ttrang126/Digital_Control_System/Digital Control_Group12.pdf

HANOI UNIVERSITY OF SCIENCE AND TECHNOLOGY SCHOOL OF ELECTRICAL AND ELECTRONIC ENGINEERING

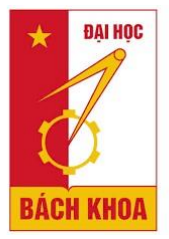
[picture p1: figure]

## PROJECT REPORT

## DIGITAL CONTROL DESIGN

## Topic: Three – phase DC/AC Inverter

## Instructor: Asso.Prof. Vu Thi Thuy Nga

Student Name | Student’s ID
Trịnh Hà Trang | 20200630
Nguyễn Thế Anh | 20200034
Nguyễn Bùi Thành An | 20202730
Nguyễn Hoàng Minh | 20207619

Ha Noi, 2024

TABLE OF CONTENTS

IMAGE INDEX

TABLE INDEX

CHAPTER 1. INTRODUCTION

### 1.1 DC/AC inverter

A DC-AC inverter is a device that converts direct current (DC) electricity into alternating current (AC) electricity. it takes power from a DC source, such as a battery or a solar panel, and transforms it into AC power that can be used to run appliances, electronic devices, or be fed into the electrical grid. The process involves changing the voltage level and waveform from the DC input to match the required characteristics of the AC output. The most common type of waveform for AC power is a sine wave, but some inverters may produce a modified sine wave or a square wave, which is generally suitable for simpler electronic devices.

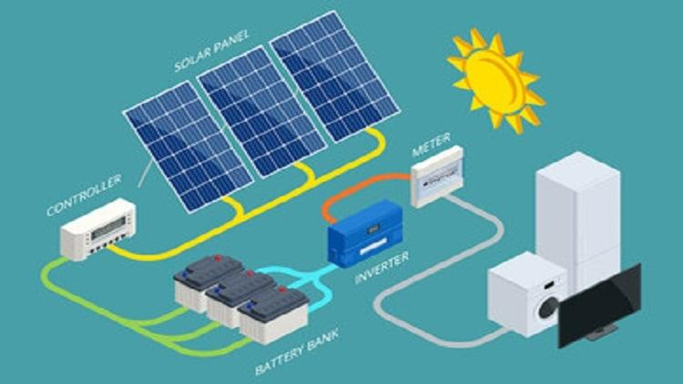
[picture p2: figure]

Figure 1. An example of an inverter application When it comes to voltage source inverter(VSI) there are two common types: the single-phase and the three phase one. While the single-phase voltage source inverter (VSI) covers low-power applications, the three- phase VSI outperforms in the medium to high-power range, and the output of the three-phase VSI can be either synchronized with the grid voltage or only supply a residential load, depending on the applications and consumers power demand. There are two types of three-phase VSI: grid-tied and off-grid inverters, each of which is installed in a different circumstance and has different requirements. Off-grid three-phase VSI, which provide conditioned and uninterrupted power to critical loads such as telecommunication systems, data centers, airline computers, medical systems, and even an industrial site or a rural community when power outages occur by transferring backup energy stored in batteries, is widely used in Uninterruptible Power Supply (UPS) systems.
Furthermore, in recent years, both standby and grid-tied three-phase VSI have been seen being implemented in a Distributed Generation System (DGS) using renewable sources such as solar cells, fuel cells, wind turbines, biomass, and so on to relieve the burden on conventional grid utilities while meeting strict environmental requirements. When the DGS system is linked in parallel with the main grid, the three-phase VSI not only injects appropriate AC power into the grid, but it also contains features that deal with the islanding effect and provides grid inspection.

### 1.2 Structure & Working Principle

Figure 2 demonstrates the standard three-phase VSI structure. A three-phase VSI typically consists of two major components, the first of which is a DC voltage source. The DC voltage source can come from a storage bank such as a battery, a supercapacitor, or the output of a previous DC-DC converter. A DC-link capacitor after the input DC voltage source may be required in some cases to maintain a constant voltage across the inverter and protect it from voltage spikes, surges, and electromagnetic interference (EMI).

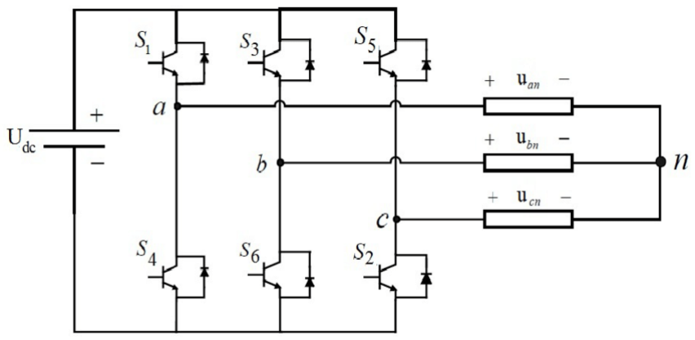
[picture p3: figure]

Figure 2. Standard 3-phase inverter Furthermore, the inverter is made up of six fully adjustable power switches that might be implemented with semiconductor devices such as GTOs, MOSFETs, or IGBTs. These devices are typically chosen depending on the switching frequency and power capacity requirements. Allowing the switches to conduct at the same time will result in a short circuit across the DC source. Similarly, the switches should not be turned off at the same time to avoid undefined output AC voltages and VSI states. In addition, when driving an inductive load, antiparallel diodes (or inverse-parallel diodes) must be added to provide reverse current routes to the source when the switch is turned off.
The correct output waveform of the three-phase inverter can be seen in Figure 3 below. In this figure the voltage is controlled by the SVPWM carrier signal. It is important to note that the waveform should be sine to optimally reduce harmonica and disturbances.

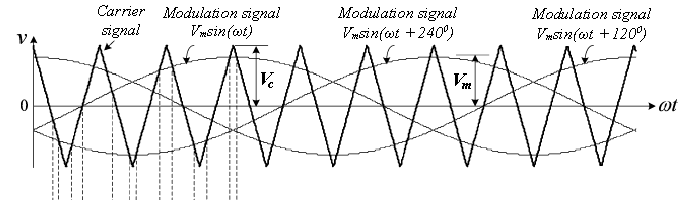
[picture p4: figure]

Figure 3. Ideal output waveform of the three-phase inverter

### 1.3 Design Criteria

### 1.3.1. For inverter design

Rated power | 48VA
Input DC voltage | 24V
Output voltage | 12V (RMS)
Output fundamental frequency | 50Hz
Power factor | 0.8
Maximum clock frequency | 80MHz
Sensor | Voltage Sensor, Current Sensor

### 1.3.2. For controller design

- Expect no overshoot.
- Short settling time
- Low harmonic distortion
- Can work with different type of loads.
For this project we will only use resistance load.

CHAPTER 2. SYSTEM MODELING AND CONTROL DESIGN

### 2.1. Space Vector Pulse Width Modulation (SVPWM)

SVPWM is a modulation technique used to control the voltage applied to a three-phase electric motor, whether it is a permanent magnet or an induction machine. The purpose is to generate a three-phase sinusoidal waveform with adjustable frequency and amplitude using a constant DC voltage and six switches, such as transistors. To apply SVPWM, the Clark Transformation method must be employed.

### 2.1.1. Clark Transformation

Consider the three-phase voltage/current system X = (Xa, Xb, Xc

) and Xa = Xb = Xc = 0.

By Clark transformation, it equals to a space vector:

u̅ =

2
3

(ua + aub + a

2uc)

where a = e

j

2π
3 = −

1
2

+ j

√3
2
Express on alpha – beta axis:

{

Uα =

1
3

(2uA − uB − uC

)

Uβ =

1
√3

(uB − uC)

Express by transformation matrix:

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
[uA | uB | uC]

= T1

[uA | uB | uC]

If
{

uA = U

mcos (ωt)

uB = U

m cos (ωt −
2π
3

)

uC = U

m cos (ωt +
2π
3

)

Then u̅ is rotating vector: u̅ = U

me

j(ωt)

### 2.1.2. Working principle of SVPWM

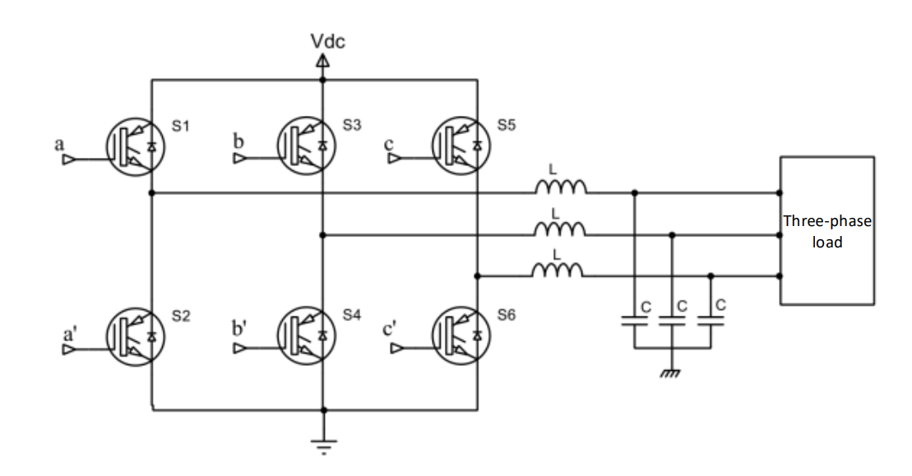
[picture p5: figure]

Figure 4. Three phase voltage source PWM inverter The circuit model of a typical three-phase voltage source SVPWM inverter is shown in Fig. 4. S1 to S6 are the six power switches that shape the output, which are controlled by the switching variables a, a′, b, b′, c and c′. When an upper transistor is switched on, i.e., when a, b or c is 1, the corresponding lower transistor is switched off, i.e., the corresponding a′, b′ or c′ is 0. Therefore, the on and off states of the upper transistors S1, S3 and S5 can be used to determine the output voltage.
There are eight possible combinations of on and off patterns for the three upper power switches. The on and off states of the lower power devices are opposite to the upper one and so are easily determined once the states of the upper power transistors are determined. The relationship between the vector space and the corresponding switching states is shown in Table 1.

Table 1. Switching states and voltage values of the vectors

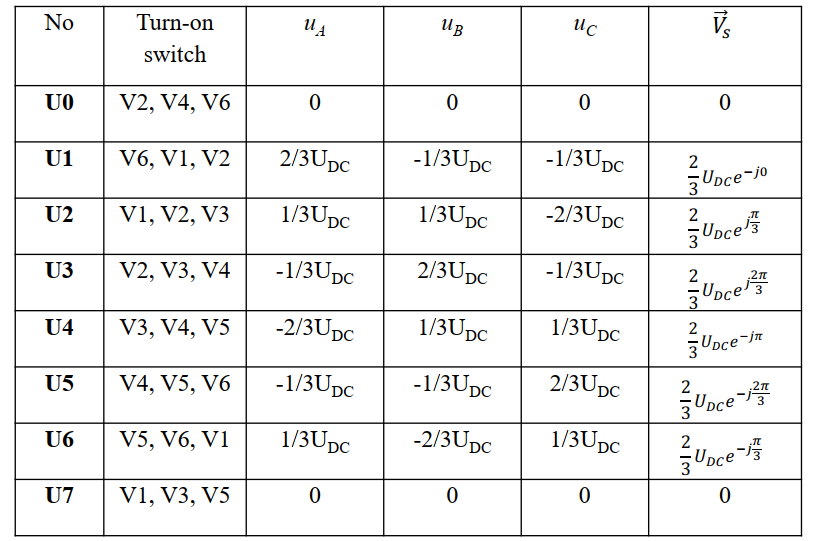
[picture p6: figure]

The space vector diagram is depicted in Fig 5.

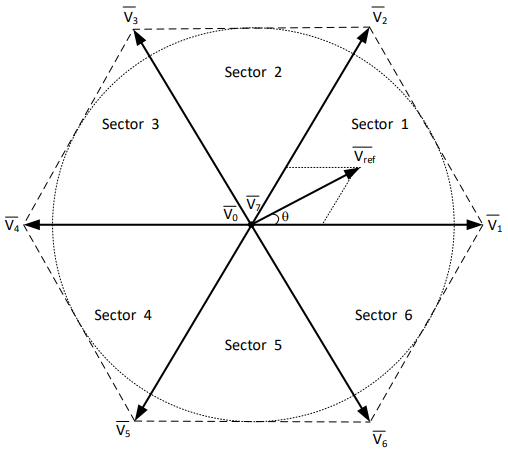
[picture p7: figure]

Figure 5. Voltage Space Vectors To generate a sinusoidal three-phase voltage for the motor we have to construct a vector that rotates in plane space called the reference voltage vector Vref ⃗⃗⃗⃗⃗ . The reference voltage

vector rotates in space with angular velocity ω = 2πf , where f is the fundamental frequency of the drive output voltage. As a result, when the reference voltage vector rotates one revolution in the space plane, the drive output changes one electrical cycle over time. The inverter's output frequency is equal to the rotation speed of the reference voltage vector.
The usual implementation of SVPWM involves the following steps:

(1) The coordinate transformation for the reference vector Vref ⃗⃗⃗⃗⃗ . from a rotating frame

to a stationary one.
(2) Define the time interval T1, T2, and T0.
(3) Determine the switching time of each Transistor (S1 - S6). The inverter cannot directly generate the desired reference voltage vector. The reference vector can be decomposed into two component vectors that lie on two other nonadjacent vectors and two zero vectors at the origin of the coordinate. Fig. 6 shows space vector PWM switching patterns at each sector.

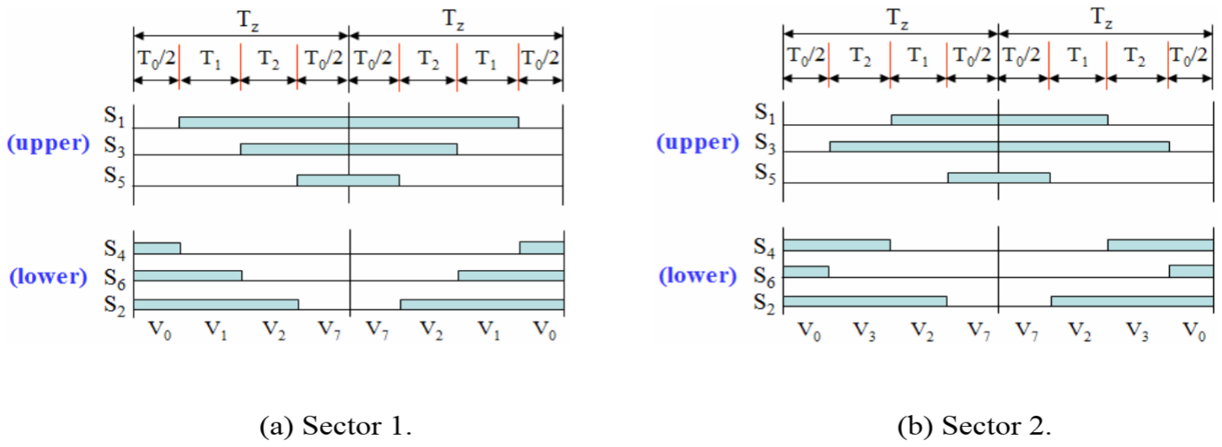
[picture p8: figure]
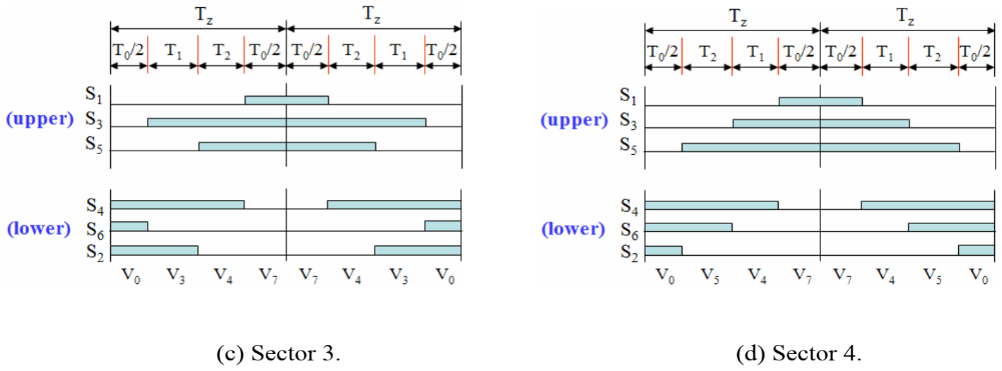
[picture p9: figure]
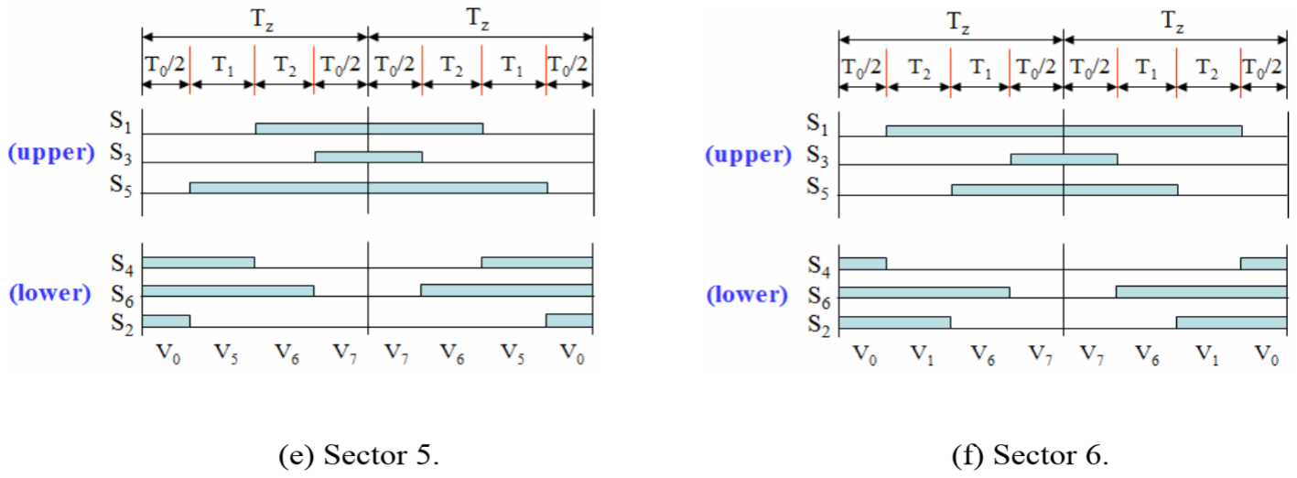
[picture p10: figure]

Figure 6. Space Vector PWM switching patterns at each sector

### 2.2. Mathematical Modeling of Three – phase Inverter

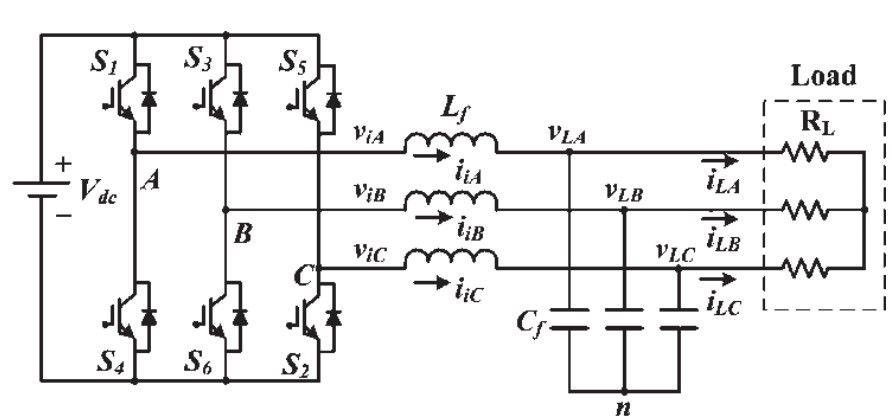
[picture p11: figure]

Figure 7. Schematic diagram of the three-phase inverter with resistance load

T Vi = [ViA ViB ViC] | Inverter output line to neutral voltage vector
Ii = [IiA IiB IiC] T | Inverter phase current vector
VL = [VLA VLB VLC] T | Load line to neutral voltage vector
T IL = [ILA ILB ILC] | Load phase current vector
T Vid-q = [Vid Viq] | d-q frame voltage vector of Vi
Iid-q = [Iid Iiq] T | d-q frame current vector of Ii
VLd-q = [VLd VLq] T | d-q frame voltage vector of VL
T Viα-β = [Viα Viβ] | α-β frame voltage vector of Vi
T Iiα-β = [Iiα Iiβ] | α-β frame current vector of Ii
VLα-β = [VLα VLβ] T | α-β frame voltage vector of VL

Fig. 7 illustrates a three-phase DC-AC inverter, incorporating an LC filter. The system includes a three-phase inverter (S1 to S6), output filters (Lf and Cf), a three-phase

resistive load (RL

), and a DC voltage source (VDC). The LC filter is a critical component of this circuit, responsible for eliminating harmonic components of the inverter's output voltage resulting from high frequency switching actions.
Applying Kirchoff’s Voltage Law and Kirchoff's Current Law at the output of the LC filter, we obtain:

{

dVL
dt

=
Cf

Ii −
Cf

IL

dIi
dt

+

rL
Lf

Ii =

1
Lf

Vi −

1
Lf

VL

(1)

Clark Transformation:

Xαβ = xae

j0 + xbe

j

2π
3 +xce

j

4π
3
where Xαβ = xα + jxβ

Eq. 1 can be transformed to the following:

{

dVLαβ
dt =

1
Cf

Iiαβ −

1
Cf

ILαβ

dIiαβ
dt +

rL
Lf

Iiαβ =

1
Lf

Viαβ −

1
Lf

VLαβ

(2)

Park Transformation:
Xdq = xd + jxq = Xαβe

−jθ

where θ(t) = ∫ ω(τ)dτ + θo

t
0

is the transformation angle, ω is the angular frequency (ω = 2πf)

Eq. 2 can be transformed to the following:

{

dVLdq
dt + jωVLdq =

1
Cf

Iidq −

1
Cf

ILdq

dIidq
dt +

rL
Lf

Iidq + jωILdq =

1
Lf

Vidq −

1
Lf

VLdq

(3)

Eq. 3 can be expressed as:

{

v̇Ld = ωvLq −

1
Cf

iLd +

1
Cf
iid | (4)

v̇Lq = −ωvLd −

1
Cf

iLq +

1
Cf
iiq | (5)

iiḋ +

rL
Lf

iid = −

1
Lf

vLd + ωiiq +

1
Lf
vid | (6)

iiq̇ +

rL
Lf

iiq = −

1
Lf

vLq − ωiid +

1
Lf
viq | (7)

### 2.3. Control design

The block diagram of the three – phase inverter control is shown in Fig 9.

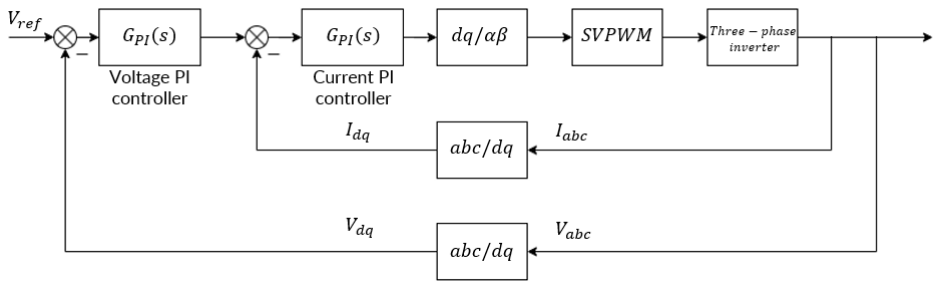
[picture p12: figure]

Figure 8. Block diagram of the three - phase inverter control

To approach the digital control of this system, we decided to first design the system in continuous domain, find the parameters for the continuous PI controllers and from that, approximate to find the parameters for the discrete PI controllers. The transfer function of PI controller is:
GPI(s) = KP (1 +

1
Tis
) | (8)

A two-loop design is considered in this project, with the outer loop is the voltage loop which uses the output voltage as feedback, while the inner loop is the current loop. The design sequence is to first starts with the current loop, then the voltage loop. Note that since the two-loop is designed in dq frame, there exists a cross-coupling between d and q-axis components in both loops, which reduces the overall dynamic and steady-state of the system. It is essential to use decoupling methods to avoid the mentioned phenomena.

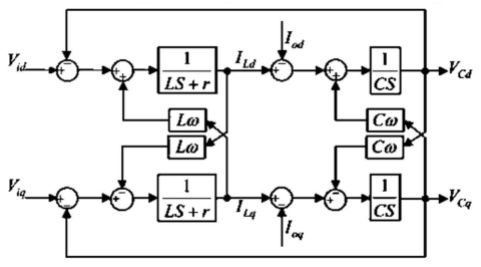
[picture p13: figure]

Figure 9. Decoupling methodology for three – phase inverter modeling in dq frame

### 2.3.1. Inner current control loop

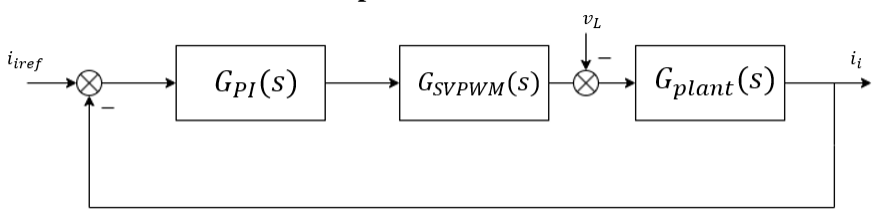
[picture p14: figure]

Figure 10. Block diagram of the current control loop

From (6), (7), we have
{
Lf

dvid
dt

+ rL

iid = −vLd + Lfωiiq + vid

Lf

viq
dt

+ rL

iiq = −vLq − Lfωiid + viq

(9)

It is clearly seen in Eq. (9) that the injected AC current can be controlled by regulating the output voltage of the DC/AC converter. However, the d- and q- axis output
currents | are | coupled | to | each | other, | leading | to | a | slightly | complicated
system from the control perspective. In addition, the load voltage also has an influence on the control dynamics. Therefore, the output voltage references (i.e., vid,ref and viq,ref ) are modified by means of adding one decoupling term and

one feed-forward voltage as
{

vid,ref = −vLd + ωLfiiq + vid

viq,ref = −vLq − ωLfiid + viq

| | | | | | | | | | (10)

The current control loop after modification can be rewritten as
{
| | | Lf diid dt | + rL
iid = vid,ref
| | | Lf diiq
dt
| | | | + rL

iiq = viq,ref

| | | | | | | | | | (11)

in which the d- and q-axis output currents (i.e., the current injected to the load) are decoupled, as shown in Fig. 4. Moreover, as it is shown in Eq. 11, the d- and q-axis
output | current | expressions | are | identical. | Thus, | the | analysis | on | one
axis is sufficient, as they share the same dynamics. Accordingly, the plant transfer functions from the converter output voltage references to the output current currents can be obtained as
| | | | Gplant = | Ii (s) Vi (s) = | 1 rL+Lfs = | 1 rL(1+
Lf
rL
| | | | | | | | s) | | (12)

The Space vector PVM transfer function (GSVPWM(s)):

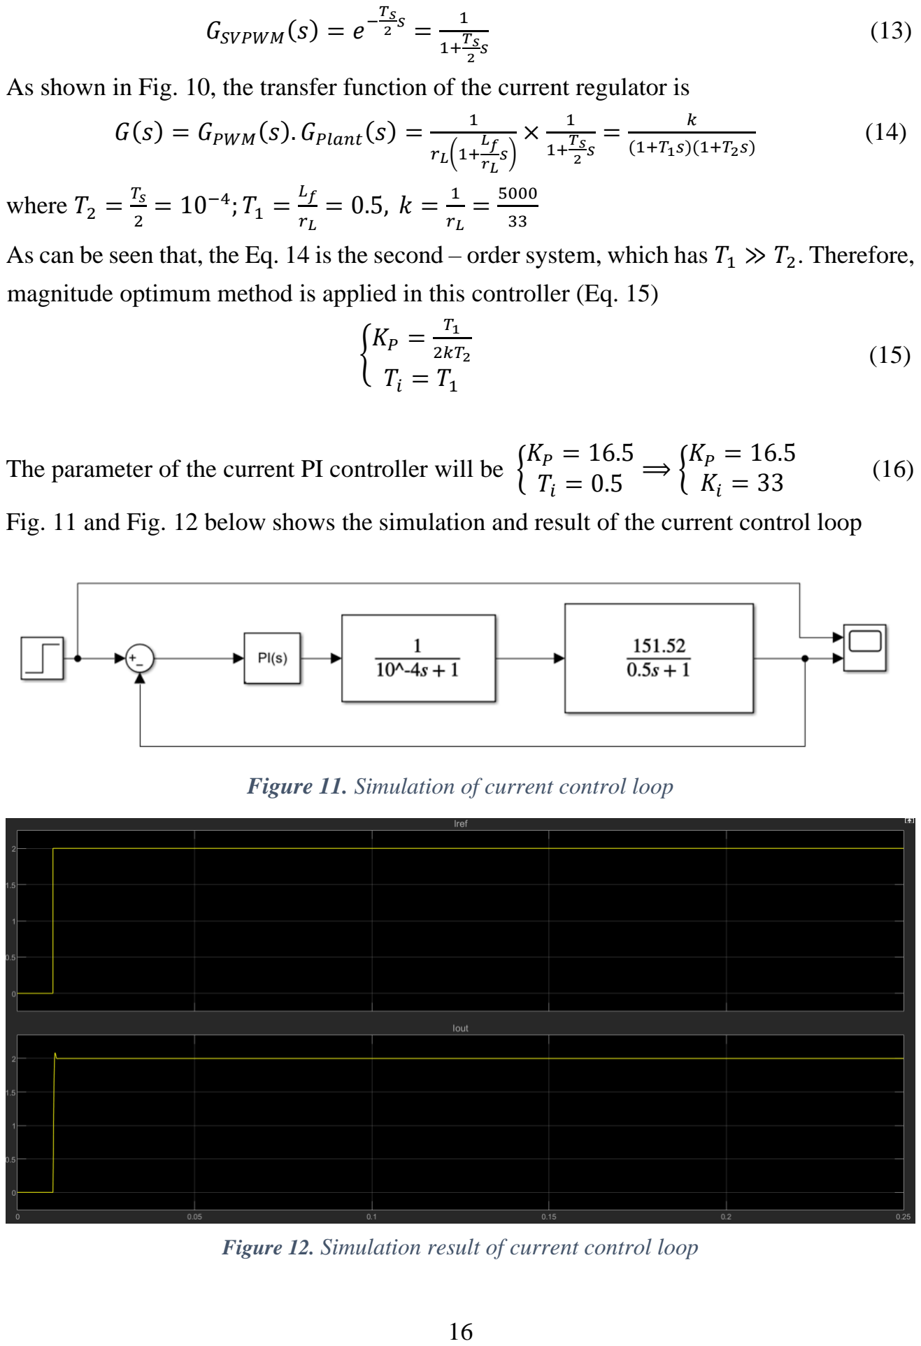
[picture p15: page 16]

GSVPWM(s) = e

−

Ts
s =
1+

Ts
2

s

(13)

As shown in Fig. 10, the transfer function of the current regulator is G(s) = GPWM(s). GPlant(s) =

1
rL(1+

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
(1+T1s)(1+T2s)

(14)

where T2 =

Ts
2

= 10⁻⁴
; T1 =

Lf
rL

= 0.5, k =

1
rL

=

5000
33
As can be seen that, the Eq. 14 is the second – order system, which has T1 ≫ T2 . Therefore,
magnitude optimum method is applied in this controller (Eq. 15)
{
KP =

T1
2kT2
Ti = T1

(15)

The parameter of the current PI controller will be {

KP = 16.5
Ti = 0.5 ⟹ {

KP = 16.5
Ki = 33 | (16)

Fig. 11 and Fig. 12 below shows the simulation and result of the current control loop

Figure 11. Simulation of current control loop

Figure 12. Simulation result of current control loop

### 2.3.2. Outer voltage control loop

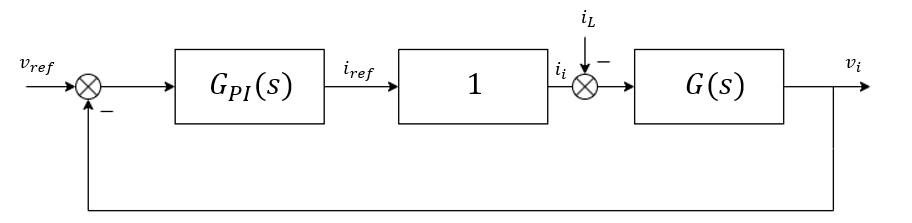
[picture p16: figure]

Figure 13. Block diagram of the voltage control loop

The response of current loop is much more faster than the voltage loop, so the transfer function of current is considered 1 (Fig. 12). From (6), (7), we have
{
Cf

dvLd
dt

= CfωvLq − iLd + iid

Cf

dvLq
dt

= −CfωvLd − iLq + iiq

(17)

Similar to the current control loop, decoupling method is also applied in the voltage control loop. Thus, the transfer function of the voltage regulator can be written as

G(s) =

Vid(s)
Iid(s)

=

Viq(s)
Iiq (s)

=

1
sCf

(18)

For choosing parameter KP,KI of the PI controller of voltage loop, MATLAB tunning is considered. We decided to choose {

KP = 0.09
KI = 20.8

(19)

Fig. 14 and Fig. 15 below shows the simulation and result of the voltage control loop

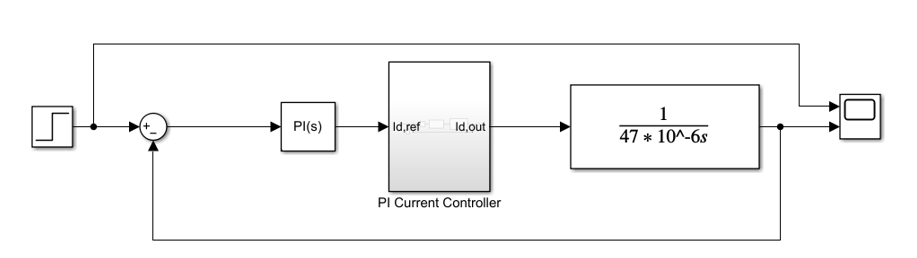
[picture p17: figure]

Figure 14. Simulation of voltage control loop

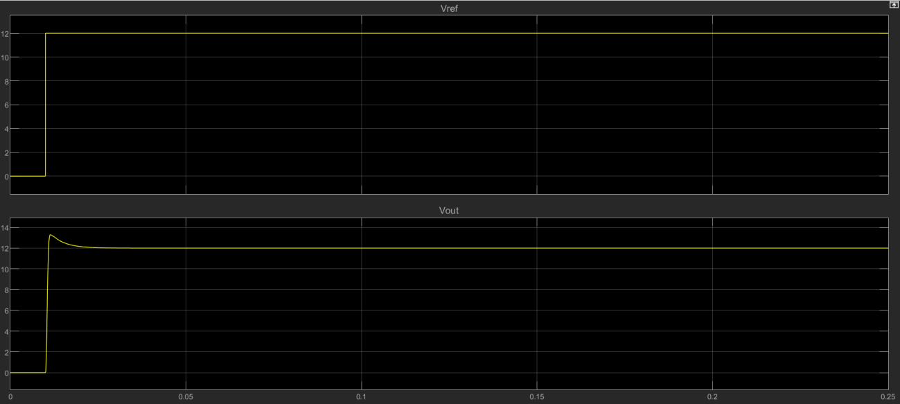
[picture p18: figure]

Figure 15. Simulation result of voltage control loop

### 2.3.3. PI controller in Z – domain

The general equation of the digital PI controller: u(t) = uP

(t) + uI(t)
+) Proportional: uP

(k) = KPe(k)

+) Integral: uI

(k) = uI

(k − 1) +

T
Ti

e(k)

⟹ u(k) = KPe(k) + uI

(k − 1) +

T
Ti
e(k) | (20)

We have: u(k − 1) = uP

(k − 1) + uI

(k − 1) ⟹ uI

(k − 1) = u(k − 1) − KPe(k − 1)

From Eq. (20):
u(k) = KPe(k) + u(k − 1) − KPe(k − 1) +

T
Ti
e(k) | (21)

⟹ u(k) = u(k − 1) + (KP +
T
Ti
) e(k) − e(k − 1)Kp | (22)

CHAPTER 3. HARDWARE SETUP

### 3.1. System specification

Table 2. System specification of three – phase DC/AC Inverter

### 3.2. Block Diagram

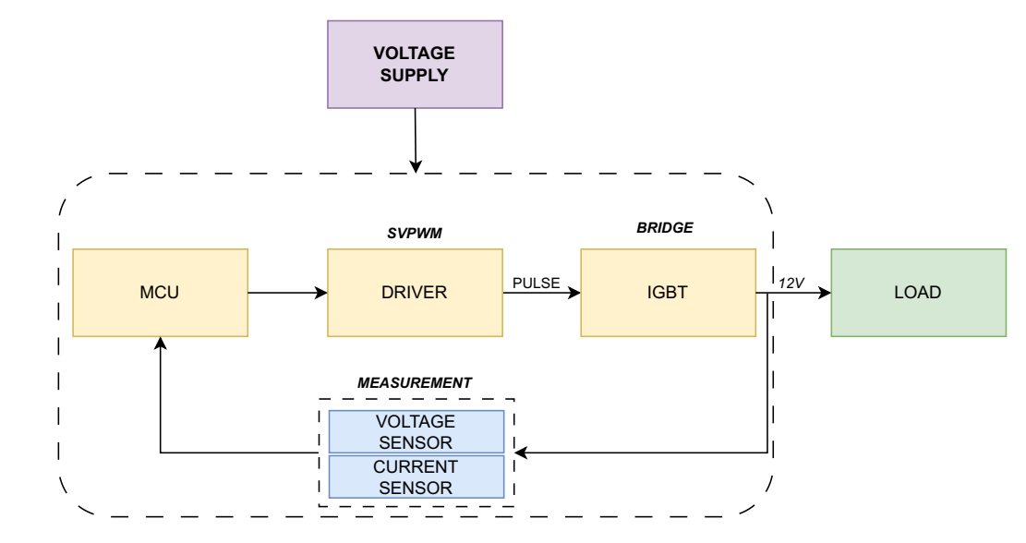
[picture p19: figure]

Figure 16. The block diagram of system

### 3.3. Calculation and Solution for components

### 3.3.1. Input for inverter (DC Voltage)

Normally, the drop voltage on the inductor in output filter equals to 10% Vout the input DC voltage, so the minimum of required DC Voltage can be calculated as following:

Input Voltage (VDC) | 24V DC
Output Voltage (VOUT) | 12V AC
Output fundamental frequency (f) | 50Hz
Output Power (Load Power) (POUT) | 8W
Switching frequency(fSW) | 5kHz

VDC_min = 1,1 ∗

√2∗Vout
0,9

= 1,1 ∗

√2∗12
0,9

= 21 (V)

Þ | Choose Vin = 24(V)
Þ | Choosing Adaptor convert AC 220V to 24V

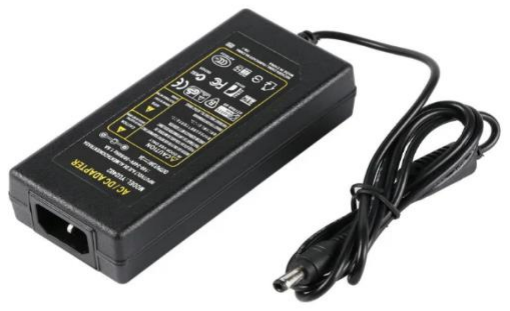
[picture p20: figure]

Figure 17. Adaptor convert 220V~AC to 24V

### 3.3.2. Output Current

Maximum current value: Iout max = √2 ∗

Sout

√3∗VOUT∗

= √2 ∗

30
3∗

12
√3

= 2(A)

### 3.3.3. IGBTs and Diode

With a power factor cos(σ) = 0,8, the avarage current flowing through IGBT is:

Iavg =

1
2π

∫ Ioutmax
sin(θ − φ) ∗ dθ =

1 + cosφ
2π

∗ Ioutmax =

1 + 0,8
2π

π

φ

∗ 2 = 0,57(A)

The avarage current flowing through antiparrallel diodes is:

Iavg =

1
2π

∫ Ioutmax
sin(θ − φ) ∗ dθ =

1 − cosφ
2π

∗ Ioutmax =

1 − 0,8
2π

φ

0

∗ 2 = 0,06(A)

Þ Choosing IGBT IRF840 MOSFET

Þ

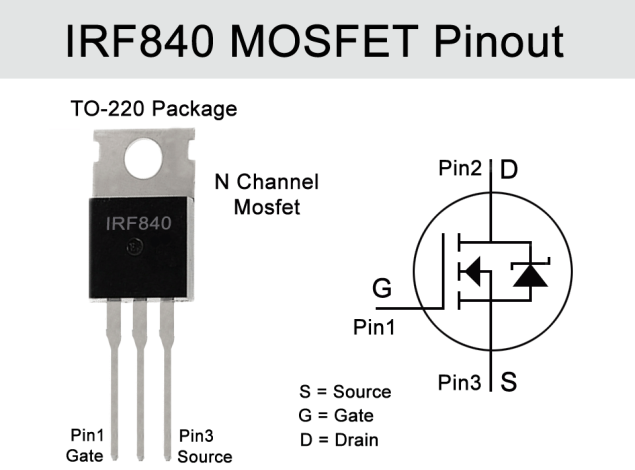
[picture p21: figure]

Þ Figure 18 .RF840 And Pin diagram

Table 3. Parameter of IRF840 MOSFET

Property | Value | Unit | Description
Type | MOSFET (N-Channel)
Continuous Drain Current (ID) | 8 | A | Maximum current the IGBT can handle continuously at 25°C case temperature.
Drain-Source Voltage (VDS) | 500 | V | Maximum voltage that can be applied between drain and source terminals.
Gate-Source Voltage (VGS) | ±20 | V | Maximum voltage that can be applied between gate and source terminals.
Threshold Voltage (VGS(th)) | 4 | V | Voltage at which the IGBT starts to conduct current.
On-Resistance (RDS(on)) | 0.85 | Ω | Resistance of the IGBT when it is turned on.
Junction Temperature (Tj) | 150 | °C | Maximum temperature allowed at the IGBT junction.

ÞChoosing IR2103 DIP8 Half-Bridge Driver with following reasons:
The (R2103 is an integrated half-bridge driver designed for driving IGBTs and MOSFETs in motor control applications.
Table 4. Parameter of IR2103
Property | Value | Unit | Description
Supply Voltage (VCC) | 7 ~ 25 | V | Operating voltage range
Output Current (Peak) | 1 | A | Maximum peak output current
Output Voltage (High) | VCC - 1.5 | V | High-level output voltage
Output Voltage (Low) | 0.3 | V | Low-level output voltage
Output Pulse Width (Typical) | 50 | ns | Typical output pulse width
Dead Time (Typical) | 500 | ns | Typical dead time between outputs
Short Circuit Protection | Yes | | Protects against short circuits
Undervoltage Lockout | Yes | | Prevents operation below VCC(UVLO)
Operating Temperature Range | -40 ~ 85 | °C | Ambient temperature range

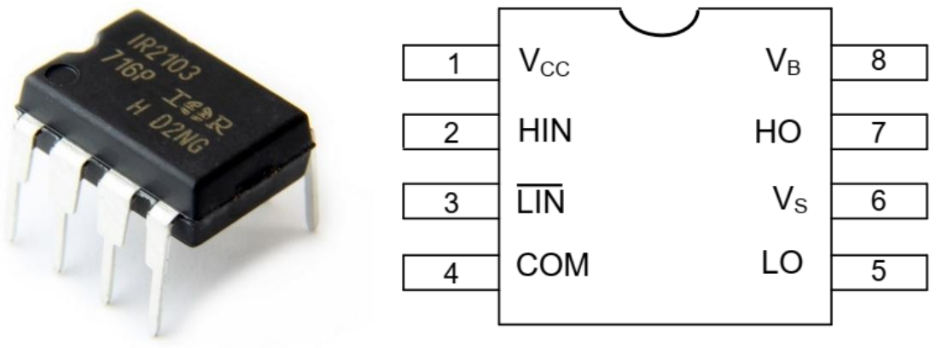
[picture p22: figure]

Figure 19. IR2103 and Pin Diagram

### 3.3.4. LC Output Filter

❖ Inductor Design:

With ∆V = 20% Vout,rms, so:

Þ ∆ V = 20% ∗ Vout,rms = 20% ∗

12
√3

= 1,39(V)

Þ Xls =

Vls

Iout,rms

=

1.39
2

= 0,695

Þ LS =

Xls
w

=

0,695
2π∗50

= 2,2 (mH)

Þ ∆IV,max =

Vin∗Ts
2Ls

=

21∗0,5∗10⁻⁴
2∗2,2∗10⁻³ = 0,24(A) → Sastify the condition above.

Þ Choose L = 3.3 mH
❖ Capacitor Design:

wLC =

1
√Ls ∗ C

= 0,1 ∗ ws = 1000π (

rad
s

)

Þ C =

1
Ls∗wLC2 =

1
2,2∗10⁻³∗(1000π)

2 = 46,24(μF)\

Þ Choose C = 47uF

### 3.3.5. Measurement Devices

❖ Current Sensor: Module ACS712-5A (Module ACS712-05B)

Table 5. Properties of ACS712

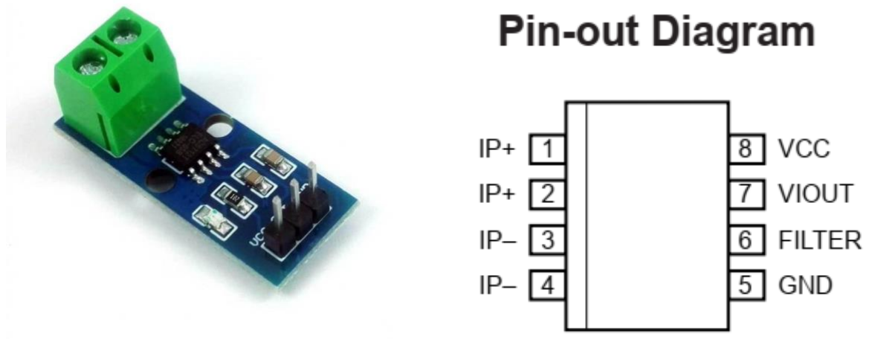
[picture p23: figure]

Figure 20. ACS712 and Pin-out Diagram

❖ Voltage Sensor: ZMPT101B

Property | Value | Unit | Description
Current Range | 5A, 20A, or 30A (model dependent) | A | Maximum measurable current
Sensitivity | 185 mV/A, 100 mV/A, or 66 mV/A (model dependent) | mV/A | Output voltage change per unit of current
Output Voltage Range | -Vcc to +Vcc | V | Output voltage swing
Supply Voltage (Vcc) | 4.5 - 5.5 | V | Operating voltage range
Bandwidth | 80 kHz | Hz | Frequency response
Accuracy | ±1.5% (typical) | % | Measurement accuracy
Temperature Drift | ±300 ppm/°C | ppm/°C | Sensitivity change with temperature

Table 6. Properties of ZMPT101B

Property | Value | Unit | Description
Voltage Ratio | 2000:1 | | Transformation ratio between input and output voltage
Accuracy | 0.1% | | Measurement accuracy
Frequency Range | 50-400 Hz | Hz | Operating frequency range
Input Voltage | 0-250 V AC | V AC | Maximum measurable voltage
Output Voltage | 0-125 mV AC | mV AC | Output voltage corresponding to full-scale input
Operating Temperature Range | -40 to 85 °C | °C | Ambient temperature range for operation

Table 7. Pins of ZMPT101B

Pin Number | Pin Name | Description
1 | Vout | Output signal pin, providing the scaled-down AC voltage (typically 0-125mV)
2 | GND | Ground connection for the transformer
3 | Vout (NC) | Not connected (no internal connection)
4 | Vin | Input voltage terminal for the primary side of the transformer (connect to the AC voltage to be measured)
5 | Vin (NC) | Not connected (no internal connection)

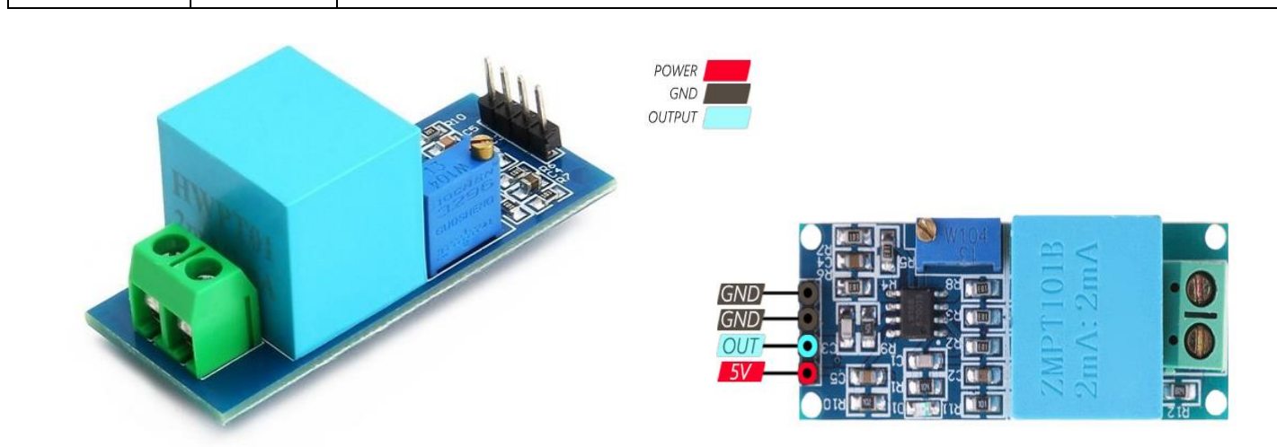
[picture p24: figure]

Figure 21. ZMPT101B and Pin-out Diagram

### 3.3.6. Microcontroller

With the simple construct and connection, so we choose kit Adruino Leonardo. The Arduino Leonardo is a microcontroller board based on the ATmega32u4. It has 20 digital input/output pins (of which 7 can be used as PWM outputs and 12 as analog inputs), a 16 MHz crystal oscillator, a micro USB connection, a power jack, an ICSP header, and a reset button. It contains everything needed to support the microcontroller; simply connect it to a computer with a USB cable or power it with a AC-to-DC adapter or battery to get started. Table 8. Parameter of Arduino Leonardo

Property | Description | Unit
Microcontroller | Atmega32u4
Operating Voltage | 3.3V
Input Voltage (recommended) | 7-12V | V
Digital I/O Pins | 14 (of which 12 provide PWM output)
Analog Input Pins | 7
DC Current per I/O Pin | 20 mA | mA
Flash Memory | 32 KB (of which 4 KB used by bootloader) | KB
SRAM | 2.5 KB | KB
EEPROM | 1 KB | KB
Clock Speed | 16 MHz | MHz
Length | 68.6 mm | mm
Width | 53.4 mm | mm
Weight | 25 g | g
Unique Properties | * Built-in USB (native USB device) * Keyboard and mouse emulation * Native MIDI support

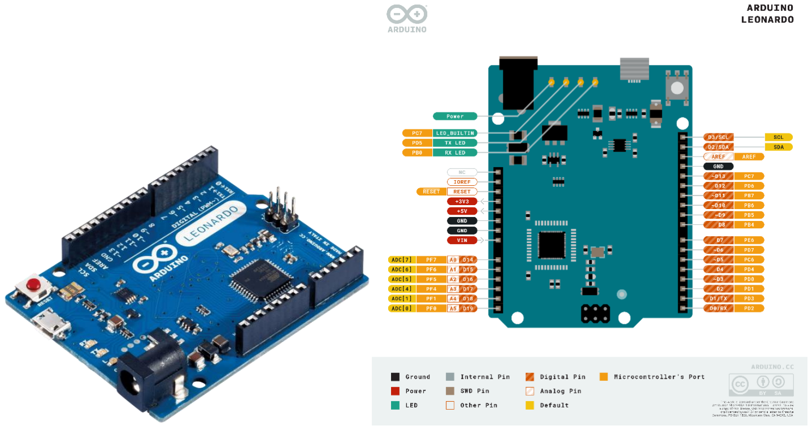
[picture p25: figure]

Figure 22. Adruino Leonardo (Left) and the Pins Diagram (right)

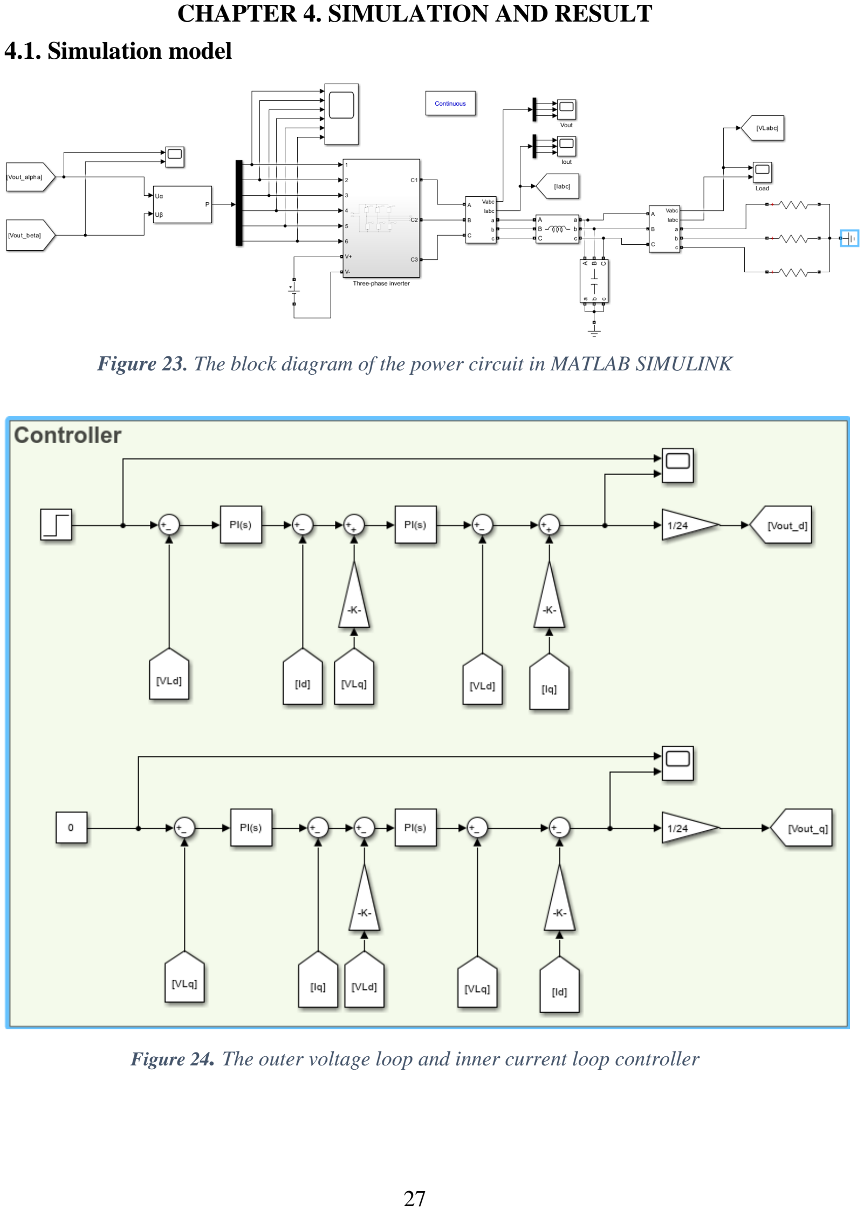
[picture p26: page 27]

CHAPTER 4. SIMULATION AND RESULT

### 4.1. Simulation model

Figure 23. The block diagram of the power circuit in MATLAB SIMULINK

Figure 24. The outer voltage loop and inner current loop controller

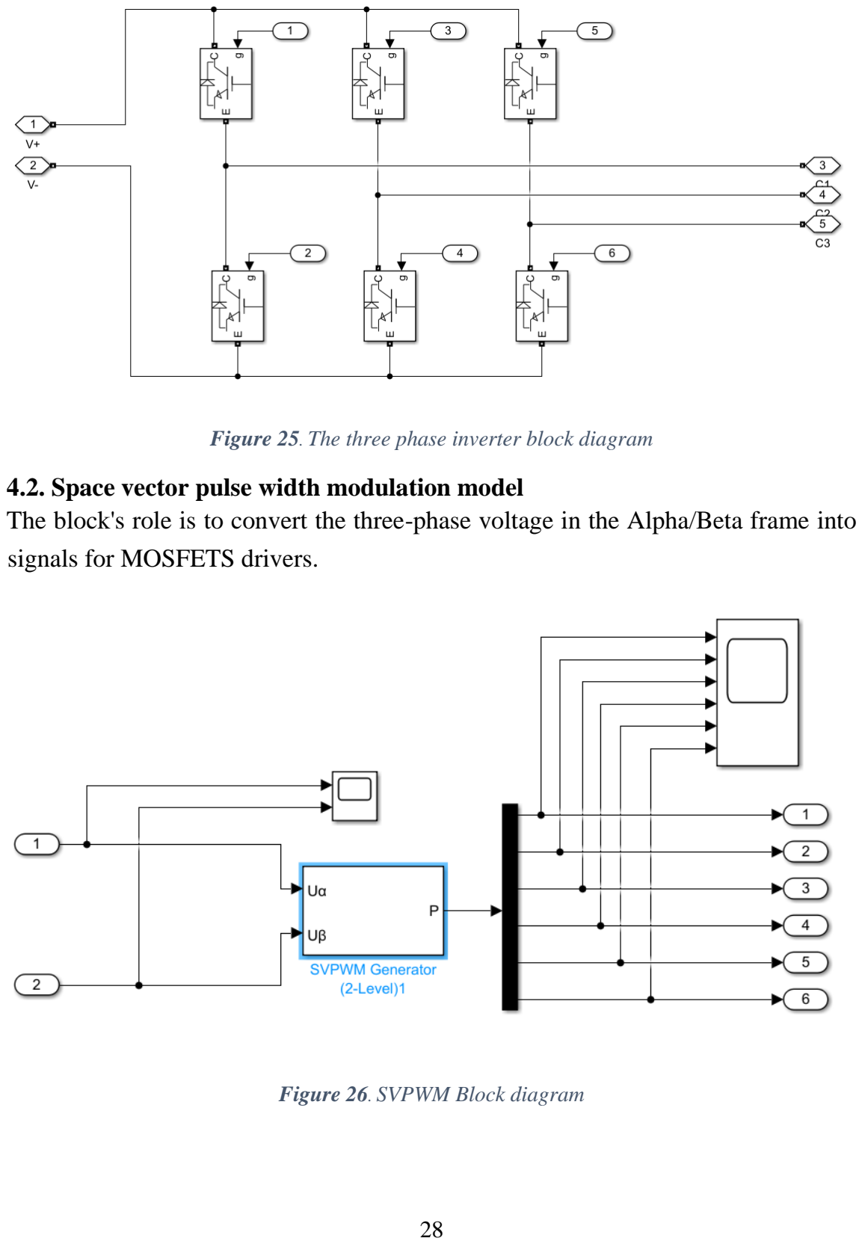
[picture p27: page 28]

Figure 25. The three phase inverter block diagram

### 4.2. Space vector pulse width modulation model

The block's role is to convert the three-phase voltage in the Alpha/Beta frame into signals for MOSFETS drivers.

Figure 26. SVPWM Block diagram

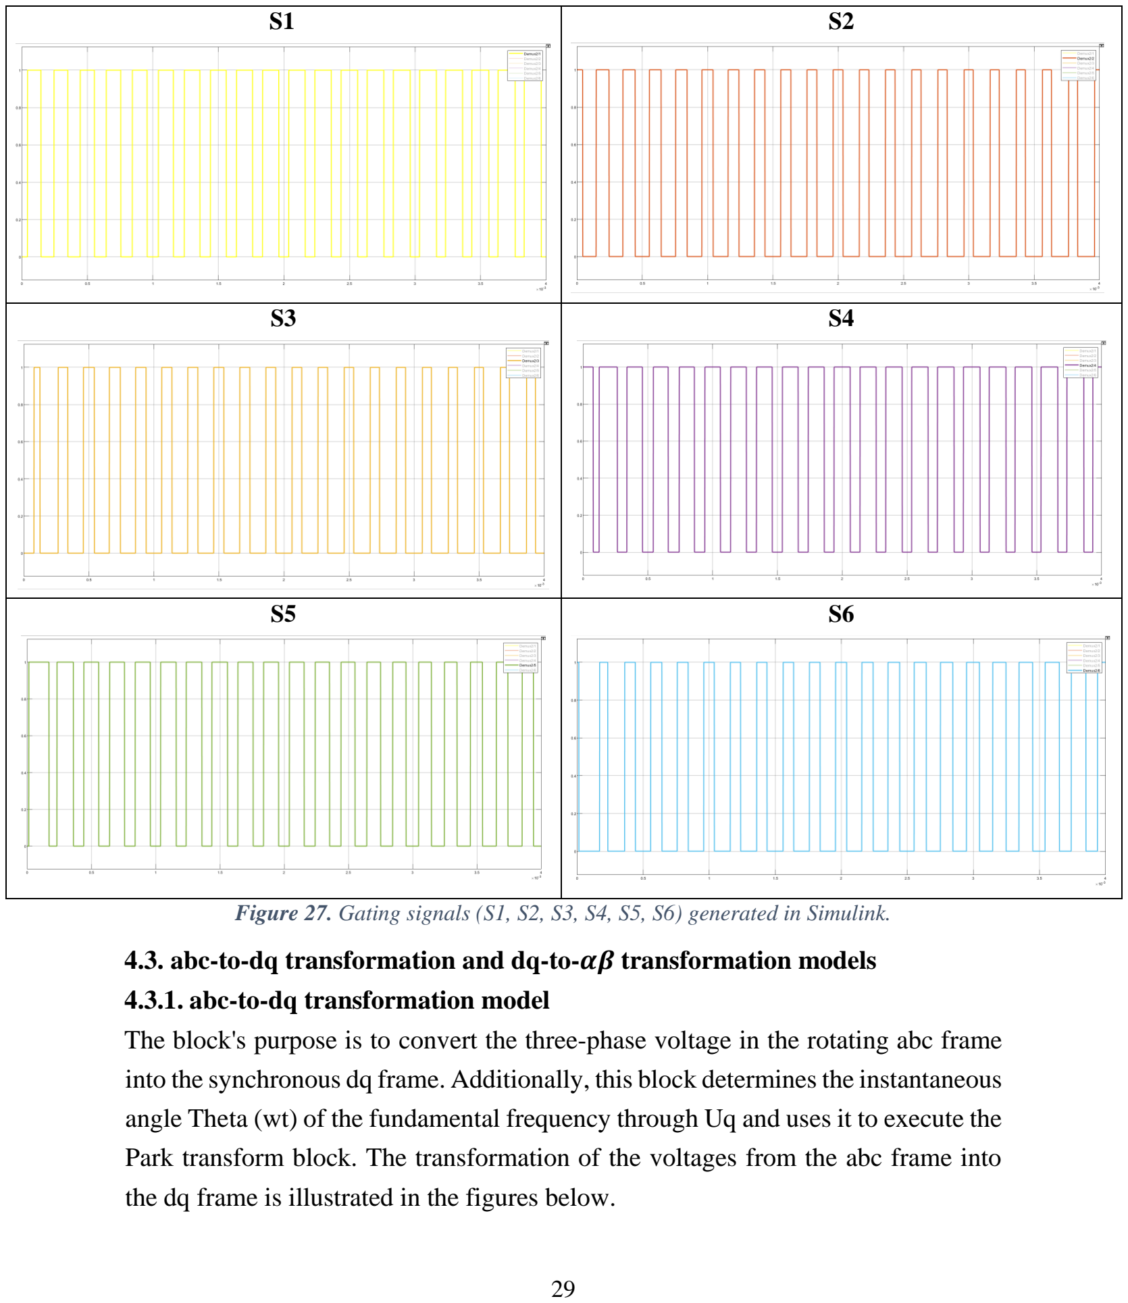
[picture p28: page 29]

S1 | S2
S3 | S4
S5 | S6

Figure 27. Gating signals (S1, S2, S3, S4, S5, S6) generated in Simulink.

### 4.3. abc-to-dq transformation and dq-to-αβ transformation models

### 4.3.1. abc-to-dq transformation model

The block's purpose is to convert the three-phase voltage in the rotating abc frame into the synchronous dq frame. Additionally, this block determines the instantaneous angle Theta (wt) of the fundamental frequency through Uq and uses it to execute the Park transform block. The transformation of the voltages from the abc frame into the dq frame is illustrated in the figures below.

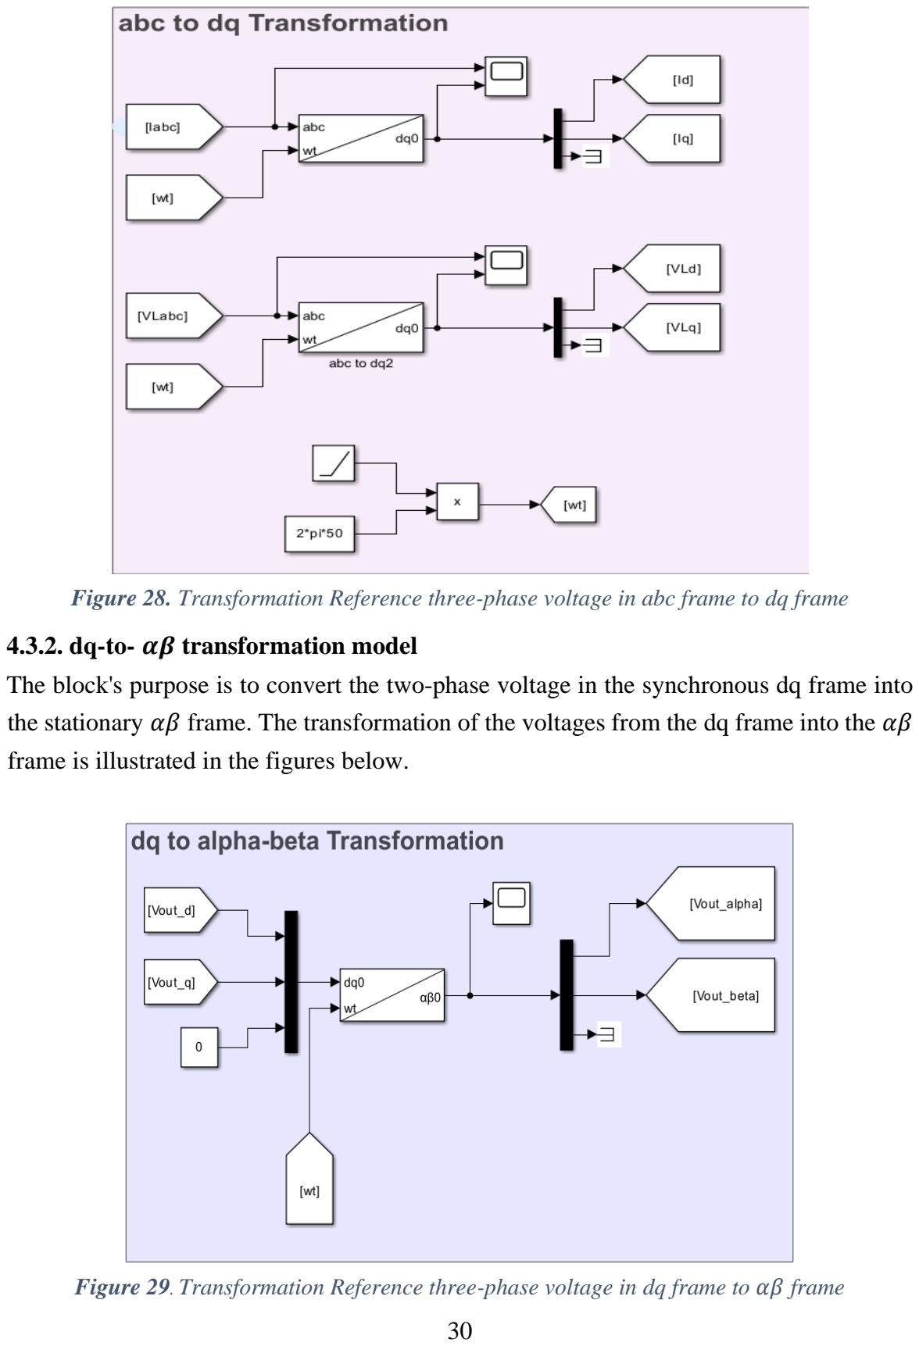
[picture p29: page 30]

Figure 28. Transformation Reference three-phase voltage in abc frame to dq frame

### 4.3.2. dq-to- αβ transformation model

The block's purpose is to convert the two-phase voltage in the synchronous dq frame into the stationary αβ frame. The transformation of the voltages from the dq frame into the αβ frame is illustrated in the figures below.

Figure 29. Transformation Reference three-phase voltage in dq frame to αβ frame

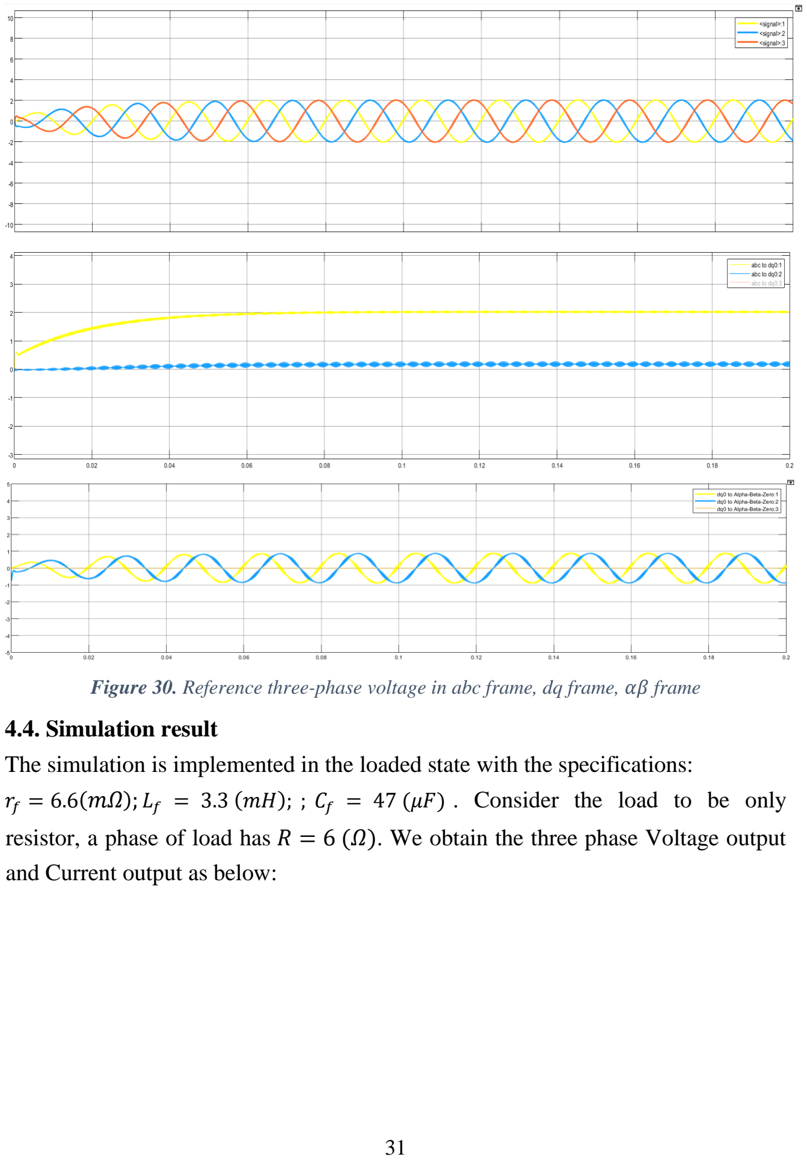
[picture p30: page 31]

Figure 30. Reference three-phase voltage in abc frame, dq frame, αβ frame

### 4.4. Simulation result

The simulation is implemented in the loaded state with the specifications:
rf = 6.6(mΩ); Lf = 3.3 (mH); ; Cf = 47 (μF) . Consider the load to be only resistor, a phase of load has R = 6 (Ω). We obtain the three phase Voltage output and Current output as below:

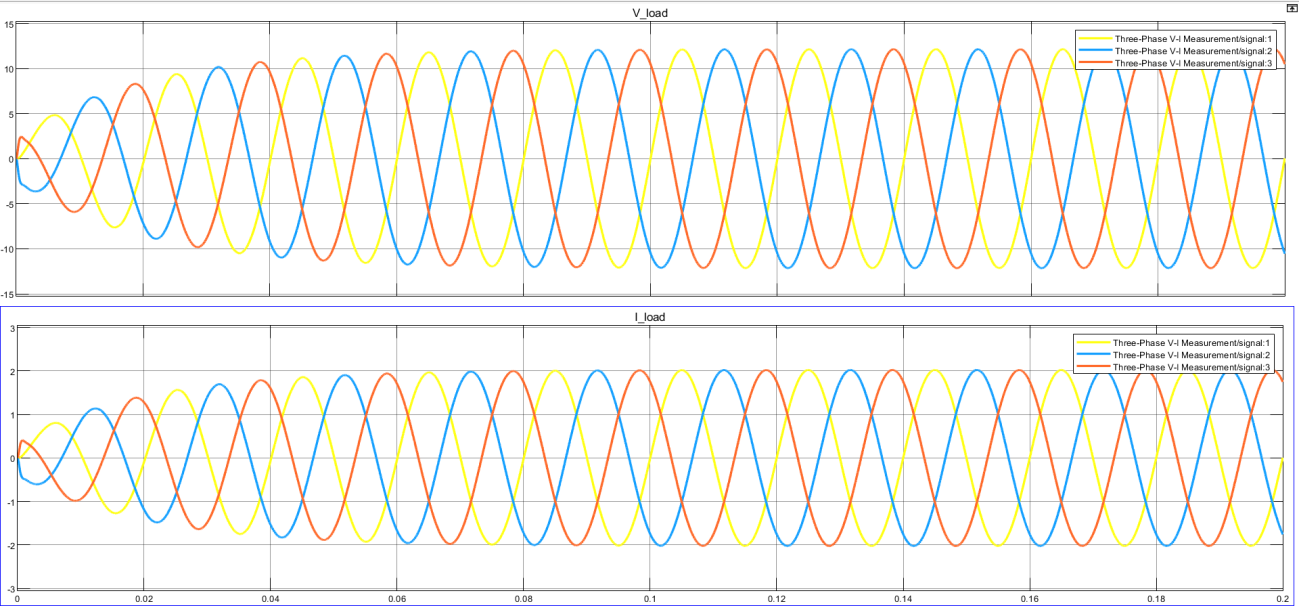
[picture p31: figure]

Figure 31. Voltage output and Current ouput of the system

CHAPTER 5. EXPERIMENTAL RESULT

Doing experiments in the laboratory, we found out that the voltage at output of load is approximately equal to 12V, with ripple about 10% because of wiring and error of measurement devices. The waveform of output voltage is not completely like the sine waveform in MATLAB Simulation.
This issue is attributed to the constraints associated with building the circuit on a breadboard, which can lead to inaccuracies in component values and energy losses that negatively impact the circuit’s performance.
Moreover, if the output is incorrect, the data obtained from voltage and current sensors will also be incorrect, which can lead to inaccuracies in the control algorithm output and affect the PWM frequency used to control the MOSFETs.

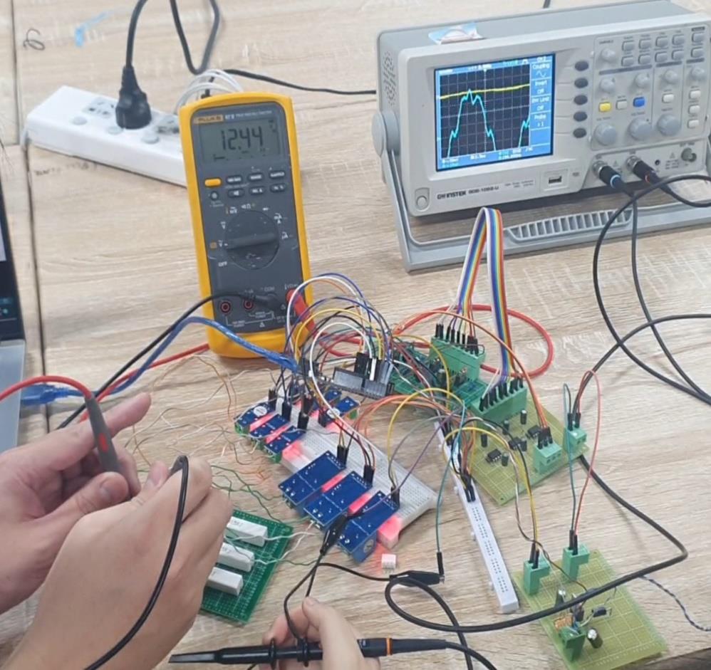
[picture p32: figure]

Figure 32. Voltage output of the system

### CONCLUSION

After one term 2023.1, the project for the “Digital Control” course, instructed

by AsscProf. Vu Thi Thuy Nga, has come to the final result. Although the difficulty of

reaching the desired goal for output voltage, the project provided us many knowledge

including power electronics, control design and control theory, as well as embedded

programming techniques.

Moving forward, we aim to expand the project by implementing our circuit on a Printed

Circuit Board and experimenting with more professional microcontrollers such as Arduino.

on the market . We extend our gratitude to AsscProf. Vu Thi Thuy Nga for her exceptional

lectures and unwavering support throughout the semester’s project progression.
