ttrang126/Digital_Control_System/(list of files, drawings)

Other design files:
HARDWARE/Current_Voltage_Sensor.SchDoc
HARDWARE/DKS.PrjPcb
HARDWARE/Driver.SchDoc
HARDWARE/Filter_Load.SchDoc
HARDWARE/IGBT.SchDoc
HARDWARE/MCU.SchDoc
HARDWARE/Power_Supply.schdoc
