ttrang126/Digital_Control_System/(commit log)

2026-02-12 Add MCU sheet
    [Current_Voltage_Sensor.SchDoc, DKS.PrjPcb, Driver.SchDoc, Filter_Load.SchDoc, IGBT.SchDoc, Power_Supply.schdoc]
2026-02-12 Add MCU schematic
    [DKS.PrjPcb, MCU.SchDoc]
2026-02-12 Done Schematic
    [Current_Voltage_Sensor.SchDoc, DKS.PrjPcb]
2026-02-13 Edit current sensor schematic
    [Current_Voltage_Sensor.SchDoc, MCU.SchDoc]
